ChrisCheang/GNCDemo/teensyGNC/teensyGNC.kicad_pcb

## KiCad design teensyGNC/teensyGNC.kicad_pcb (2026-09-21)

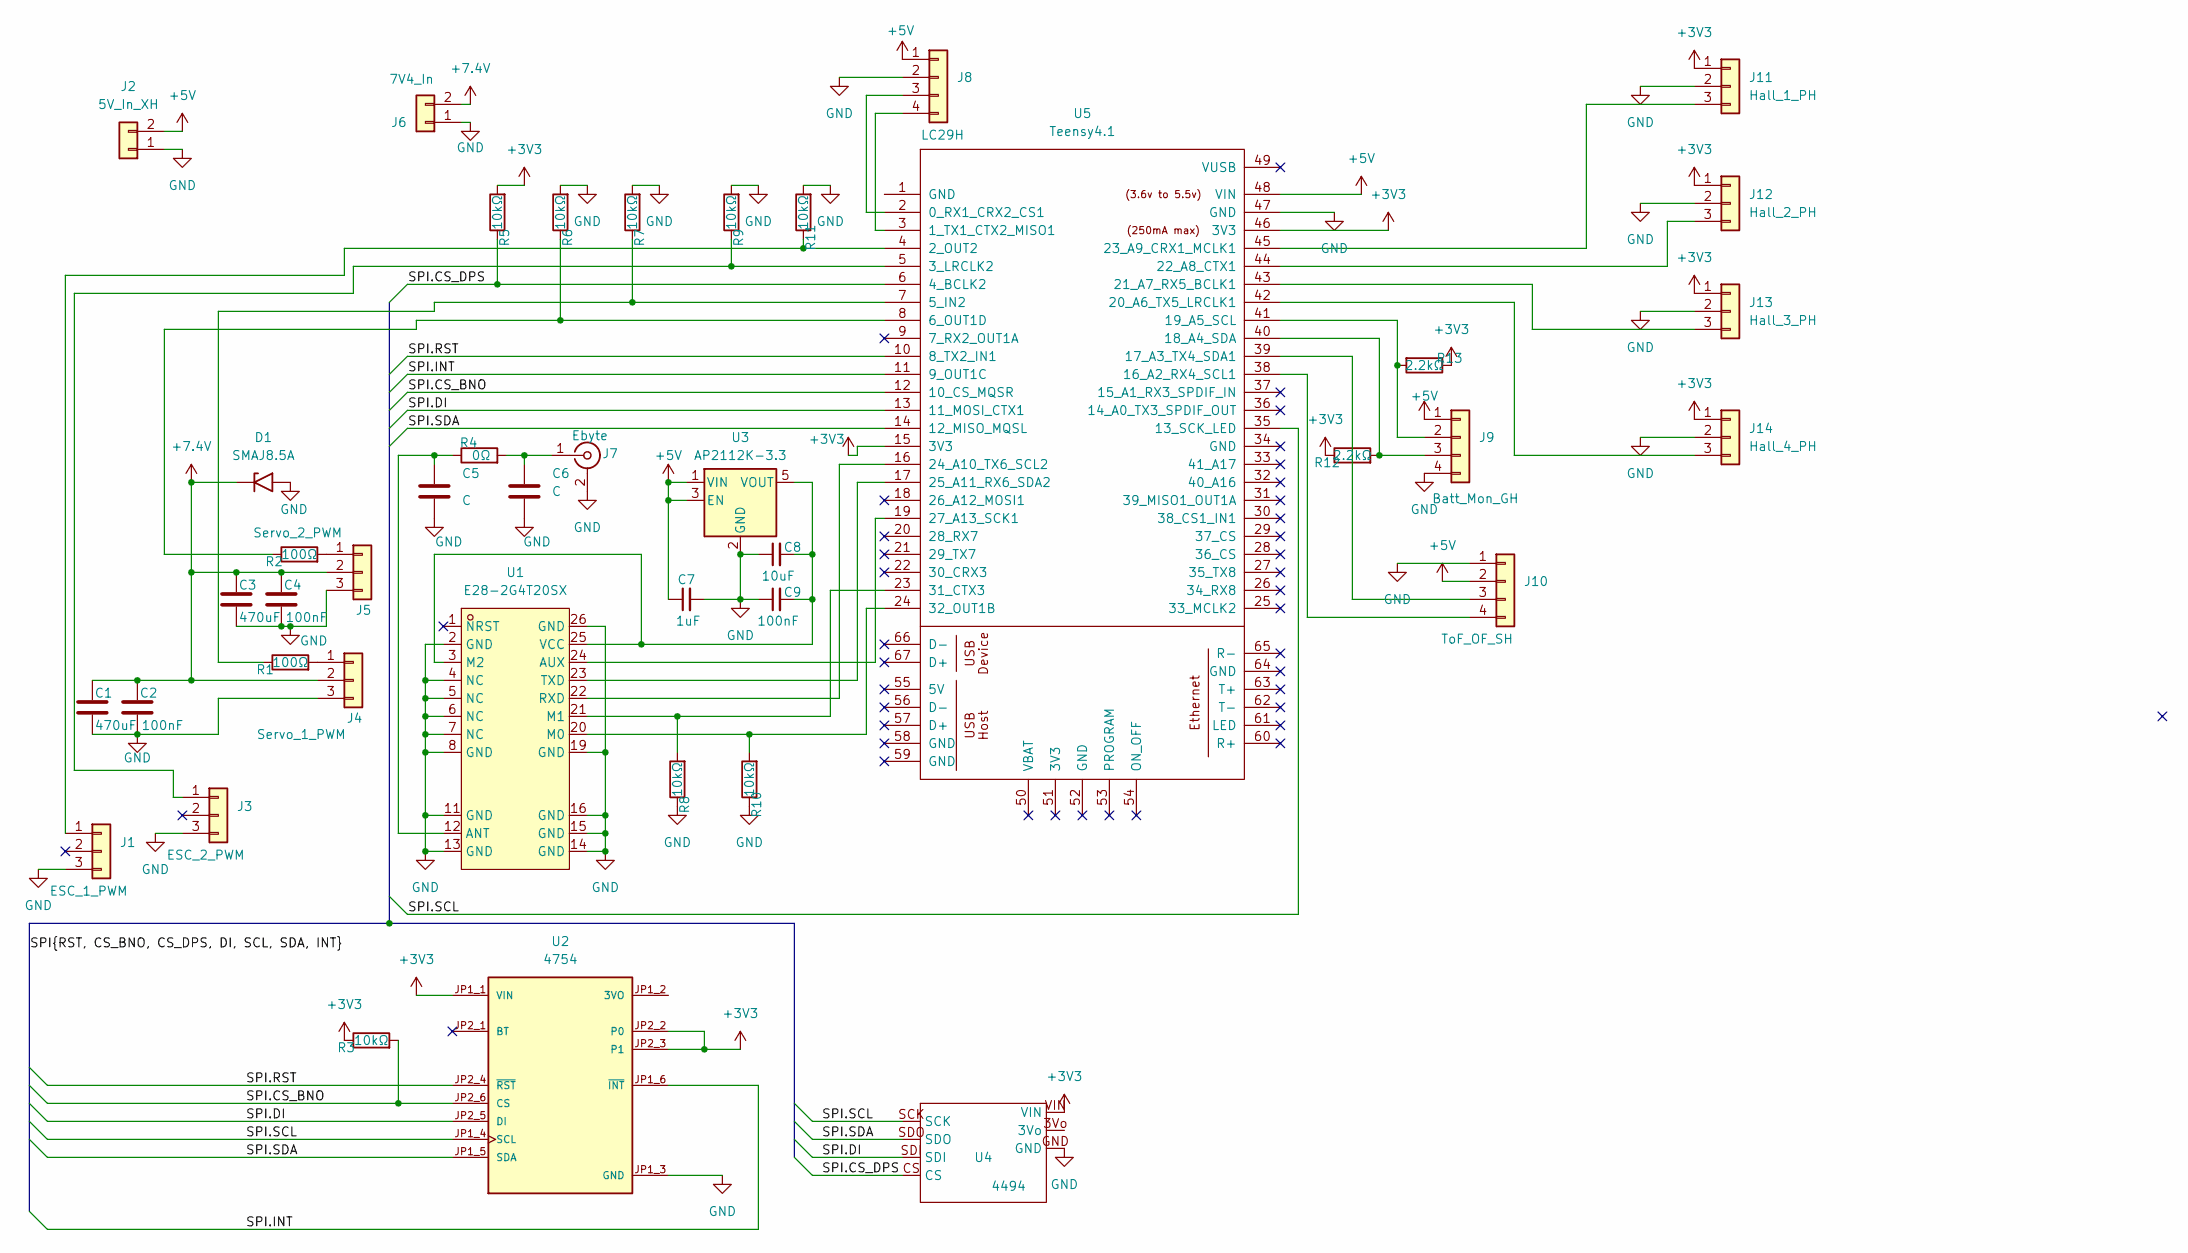
[picture p1: schematic teensyGNC.kicad_sch]

Parts:
C1, C3: 470uF; CP_EIA-7343-43_Kemet-X; LCSC Part # C7234
C2, C4, C9: 100nF; C_0603_1608Metric; LCSC Part # C14663
C5, C6: C; C_0603_1608Metric
C7: 1uF; C_0603_1608Metric; LCSC Part # C29936
C8: 10uF; C_0603_1608Metric; LCSC Part # C109457
D1: SMAJ8.5A; D_SMA; LCSC Part # C135018
J1: ESC_1_PWM; PinHeader_1x03_P2.54mm_Vertical
J2: 5V_In_XH; JST_XH_B2B-XH-AM_1x02_P2.50mm_Vertical; LCSC Part # C158012
J3: ESC_2_PWM; PinHeader_1x03_P2.54mm_Vertical
J4: Servo_1_PWM; PinHeader_1x03_P2.54mm_Vertical
J5: Servo_2_PWM; PinHeader_1x03_P2.54mm_Vertical
J6: 7V4_In; AMASS_XT30UPB-M_1x02_P5.0mm_Vertical; LCSC Part # C428721
J7: Ebyte; SMA_BAT_Wireless_BWSMA-KWE-Z001; LCSC Part # C496551
J8: LC29H; PinHeader_1x04_P2.54mm_Vertical
J9: Batt_Mon_GH; JST_GH_BM04B-GHS-TBT_1x04-1MP_P1.25mm_Vertical; LCSC Part # C161692
J10: ToF_OF_SH; JST_SH_BM04B-SRSS-TB_1x04-1MP_P1.00mm_Vertical; LCSC Part # C160390
J11: Hall_1_PH; JST_PH_B3B-PH-K_1x03_P2.00mm_Vertical; LCSC Part # C131339
J12: Hall_2_PH; JST_PH_B3B-PH-K_1x03_P2.00mm_Vertical; LCSC Part # C131339
J13: Hall_3_PH; JST_PH_B3B-PH-K_1x03_P2.00mm_Vertical; LCSC Part # C131339
J14: Hall_4_PH; JST_PH_B3B-PH-K_1x03_P2.00mm_Vertical; LCSC Part # C131339
R1, R2: 100Ω; R_0603_1608Metric; LCSC Part # C122970
R3, R5, R6, R7, R8, R9, R10, R11: 10kΩ; R_0603_1608Metric; LCSC Part # C25804
R4: 0Ω; R_0603_1608Metric; LCSC Part # C95177
R12, R13: 2.2kΩ; R_0603_1608Metric; LCSC Part # C4190
U1: E28-2G4T20SX; COMM-SMD_E28-2G4T20SX; MPN E28-2G4T20SX; LCSC Part # C42464206
U2: 4754; MODULE_4754; PARTREV 2021-03-16
U3: AP2112K-3.3; SOT-23-5; LCSC Part # C51118
U4: 4494; MODULE_4494
U5: Teensy4.1; Teensy41

Connections:
+3V3: J11.1, J12.1, J13.1, J14.1, R3.1, R5.2, R12.1, R13.1, U2.JP1_1 (VIN), U2.JP2_2 (P0), U2.JP2_3 (P1), U4.VIN, U5.15 (3V3), U5.46 (3V3)
+5V: C7.1, J2.2, J8.1, J9.1, J10.2, U3.1 (VIN), U3.3 (EN), U5.48 (VIN)
+7.4V: C1.1, C2.1, C3.1, C4.1, D1.1 (A1), J4.2, J5.2, J6.2
/SPI.CS_BNO: R3.2, U2.JP2_6 (CS), U5.12 (10_CS_MQSR)
/SPI.CS_DPS: R5.1, U4.CS, U5.6 (4_BCLK2)
/SPI.DI: U2.JP2_5 (DI), U4.SDI, U5.13 (11_MOSI_CTX1)
/SPI.INT: U2.JP1_6 (~INT), U5.11 (9_OUT1C)
/SPI.RST: U2.JP2_4 (~RST), U5.10 (8_TX2_IN1)
/SPI.SCL: U2.JP1_4 (SCL), U4.SCK, U5.35 (13_SCK_LED)
/SPI.SDA: U2.JP1_5 (SDA), U4.SDO, U5.14 (12_MISO_MQSL)
GND: C1.2, C2.2, C3.2, C4.2, C5.2, C6.2, C7.2, C8.1, C9.1, D1.2 (A2), J1.3, J2.1, J3.3, J4.3, J5.3, J6.1, J7.2 (Ext), J8.2, J9.4, J10.1, J11.2, J12.2, J13.2, J14.2, R6.2, R7.2, R8.1, R9.2, R10.1, R11.2, U1.2 (GND), U1.4 (NC), U1.5 (NC), U1.6 (NC), U1.7 (NC), U1.8 (GND), U1.11 (GND), U1.13 (GND), U1.14 (GND), U1.15 (GND), U1.16 (GND), U1.19 (GND), U1.26 (GND), U2.JP1_3 (GND), U3.2 (GND), U4.GND, U5.47 (GND)
unnamed: J1.1, R11.1, U5.4 (2_OUT2)
unnamed: J3.1, R9.1, U5.5 (3_LRCLK2)
unnamed: J4.1, R1.2
unnamed: J5.1, R2.2
unnamed: C6.1, J7.1 (In), R4.2
unnamed: J8.3, U5.2 (0_RX1_CRX2_CS1)
unnamed: J8.4, U5.3 (1_TX1_CTX2_MISO1)
unnamed: J9.2, R13.2, U5.41 (19_A5_SCL)
unnamed: J9.3, R12.2, U5.40 (18_A4_SDA)
unnamed: J10.3, U5.39 (17_A3_TX4_SDA1)
unnamed: J10.4, U5.38 (16_A2_RX4_SCL1)
unnamed: J11.3, U5.45 (23_A9_CRX1_MCLK1)
unnamed: J12.3, U5.44 (22_A8_CTX1)
unnamed: J13.3, U5.43 (21_A7_RX5_BCLK1)
unnamed: J14.3, U5.42 (20_A6_TX5_LRCLK1)
unnamed: C5.1, R4.1, U1.12 (ANT)
unnamed: U1.24 (AUX), U5.19 (27_A13_SCK1)
unnamed: R10.2, U1.20 (M0), U5.24 (32_OUT1B)
unnamed: R8.2, U1.21 (M1), U5.23 (31_CTX3)
unnamed: C8.2, C9.2, U1.3 (M2), U1.25 (VCC), U3.5 (VOUT)
unnamed: U1.22 (RXD), U5.16 (24_A10_TX6_SCL2)
unnamed: U1.23 (TXD), U5.17 (25_A11_RX6_SDA2)
unnamed: R1.1, R7.1, U5.7 (5_IN2)
unnamed: R2.1, R6.1, U5.8 (6_OUT1D)

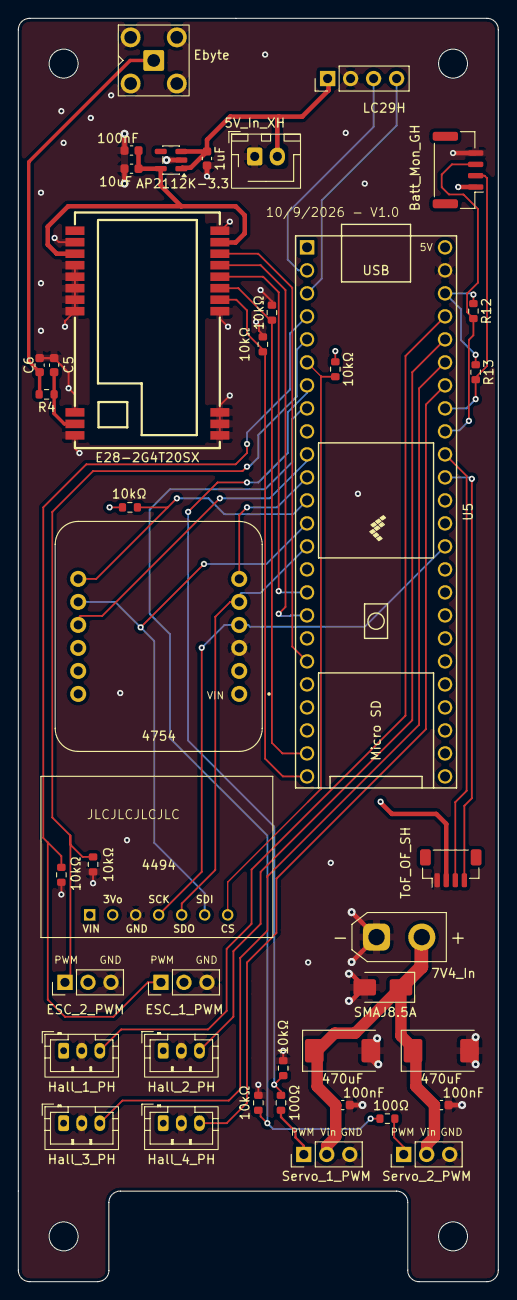
[picture p2: board teensyGNC.kicad_pcb from above]

Board: 4 copper layers, 53.0 x 139.5 mm, 42 parts (0 on the bottom side), 35 nets.
