ChrisCheang/GNCDemo/(commit log)

2026-07-16 Create IMUtest.ino
    First IMU testing code for the teensy 4.1 with SPI connection to BNO085
2026-07-16 Create IMUtest1.pde
    First version of Processing code for visualization
2026-07-17 Update IMUtest.ino
    Begins a calibration using 9-axis mode, then switches it to 6-axis game mode to remove yaw jumps as a result of magnetic interference
    [IMUtest.ino]
2026-07-17 Update IMUtest.ino
    Modified PWM signal to mirror imu roll angle on the servo, still compatible with the Processing code
2026-07-18 Create kinematics.py
    Updated version of kinematics.py from TVC-Hopper-Code to model the servo linkage kinematics in servo TVC concept 1, with a 3d visualization. So far only inverse kinematics (gimbal angles to servo angles).
2026-08-04 Update IMUtest.ino
    Slightly modified version with more adjustability for troublehshooting (in progress)
2026-08-25 Added PCB first version
    Added Kicad PCB, first version with all modules and connectors all connected (not checked yet)
    [teensyGNC.kicad_pcb, teensyGNC.kicad_sch]
2026-08-26 More amendments
    - Added mounting holes
    - Removed splits in the ground plane by removing all in1.cu plane traces
    - Added pull up/down resistors (check values)
    [teensyGNC.kicad_pcb, teensyGNC.kicad_sch]
2026-08-28 Update IMUtest.ino
    Added connection to 4494 DPS310 module, no filters or anything yet
2026-08-28 Moved LC29H onboard and to the top of the board
    [teensyGNC.kicad_pcb, teensyGNC.kicad_sch]
2026-08-30 Board width reduced
    [teensyGNC.kicad_pcb]
2026-09-02 Update IMUtest.ino
    Added single axis pwm control of one motor, 3v3 tentatively works fine for pwm control voltage. Middle of first testing period 3v3 pwm gives sufficiently stable motor speed regulation, but towards the end significant speed fluctuations (including sudden spikes to near full throttle, and motor sometimes cuts out during runs and enters beeping setups) were observed. Will need to verify if using 5v vs 3v3 is a factor to this, as well as the reason for such significant peaks. For now can remove level shifter from pcb, also recheck esc datasheet; speed fluctuations may be due to entering some sort of setup sequence due to e.g. power instabilities.
2026-09-03 Suggestions from Jack pt 1
    - LVL shifter removed, both servo and escs tested to be OK with 3v3
    - split plane removed, seems to be archaic method, and they haven't seen issues that require split ground planes to fix
    - Trace for antennae added, need to add proper components for the pi matching network and trace sizes
    [teensyGNC.kicad_pcb, teensyGNC.kicad_sch]
2026-09-04 Suggestions from Jack part 2 + some other changes
    - Ground pours on signal planes
    - Capacitors changed to flatter versions
    - Connector movements for teensy usb clearance
    - Silkscreen labels
    - Ran DRC; no errors just text warnings
    [teensyGNC.kicad_pcb, teensyGNC.kicad_sch]
2026-09-05 Small fixes
    - DRC now runs OK for all three ground pours (shifted ebyte around a little bit closer to teensy)
    [teensyGNC.kicad_pcb]
2026-09-05 DRC passed and offboard connector pinouts checked
    - All connectors vertical now for better cable management
    - LCSC numbers added as fields for jlcpcb assembly
    [teensyGNC.kicad_pcb, teensyGNC.kicad_sch]
2026-09-05 Test fabrication
    - Downloaded fabrication toolkit
    - Updated LCSC Part --> LCSC Part #
    - Test BOM and gerber creation using toolkit
    [Test_export_3_bom.csv, Test_export_3_designators.csv, Test_export_3_positions.csv, teensyGNC.kicad_pcb, teensyGNC.kicad_sch]
2026-09-06 First export sent to taobao JLCPCB for quoting + other stuff
    - Text labels added for components and connectors
    [Export_6_9_TeensyGNC_bom.csv, Export_6_9_TeensyGNC_designators.csv, Export_6_9_TeensyGNC_positions.csv, teensyGNC.kicad_pcb]
2026-09-09 V1.0 Order placed at JLCPCB
    - Some components changed to basic versions to lower cost a bit (TOTAL 96 USD!!!?? Do try and lower further for future versions, main cost seems to be extended part fees, maybe look into more hand soldered bits?)
    - Some JST connectors bought on taobao and assembled myself
    [Export_9_9_TeensyGNC_bom.csv, Export_9_9_TeensyGNC_designators.csv, Export_9_9_TeensyGNC_positions.csv, teensyGNC.kicad_pcb, teensyGNC.kicad_sch]
2026-09-10 Reorder
    Original order on 9-9 cancelled by jlcpcb for containing blind/buried vias, added DRC rule to check, removed blind/buried vias and then reordered
    [Export_10_9_TeensyGNC_bom.csv, Export_10_9_TeensyGNC_designators.csv, Export_10_9_TeensyGNC_positions.csv, teensyGNC.kicad_pcb]
2026-09-13 Update IMUtest.ino
    Added watchdog timer (but main improvement to increased stability is probably the switch to PDB BEC and better power connectiors) and first testing version of the kalman filter (+ added some foam to the dps310, but may not be thick enough, need more testing, focus on filter first), parameter tuning and read up next
    [IMUtest.ino]
2026-09-20 Create altkalman.ino
    First working version of altitude kalman filtering using a 2DoF linear kalman filter. Process noise Q is very low (trusts the instantaneous changes of the accelerometer more, note that the accelerometer imu feeds into the prediction step as it is directly a part of the system model) and measurement noise R high (doesn't trust barometer instantaneous movements and transients, so kalman gain K, i.e. the contribution given to the final updated altitude, is very low), such that instantaneous movements are captured with the accelerometer, while the barometer corrects drift. Note that as long as K is not exactly zero, it multiplies with the innovation (difference between measu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
    [altkalman.ino]
2026-09-21 Update altkalman.ino
    First on vehicle board test, switched acceleration direction from Z+ (breadboard testing) to X+ (vehicle mounting)
2026-09-21 ! CRITICAL FIX !
    5V Input plug was placed the wrong way around, now flipped back to the correct direction on the board. For the V1.0 deliveries, the first board might have had its ebyte power voltage converter fried (not tested yet), jst xh flipped manually (steps in notebook) for successful testing of altitude control on vehicle. For second board, will need to flip the jst xh first.
    [teensyGNC.kicad_pcb, teensyGNC.kicad_sch]
2026-09-23 Update IMUtest.ino
    First tests of integrated servo action on the vehicle
2026-10-03 Update altkalman.ino
    Corrected roll calculation and updated body frame (north west up when in static condition)
    [altkalman.ino]
2026-10-05 Update wiredtelemetry.py
    Changed 3D axes to a top down 2D motion plot
2026-10-05 Update wiredtelemetry.py
    Fixed 2D window size
    [wiredtelemetry.py]
2026-10-05 Update altkalman.ino
    - NWU frame quaternion compensation completed
    - 6d kalman filter partially implemented with altitude gyroscope compensation done
    - Optical flow data reads successfully, but compensation is not yet implemented correctly
    [altkalman.ino]
2026-10-06 Update altkalman.ino
    Note: optical flow still doesn't work, saving here for easier iteration and trials of modified older versions
    [altkalman.ino]
2026-10-07 Update altkalman.ino
    Best version of optical flow so far, for some reason removing the compensation terms (even though the mtf-01p doesn't seem to have an on board gyro) provides better results overall, even if pitch and yaw is still not being compensated. Will try another method (using qw, qx, qy, qz to calculate the expected deviation of the camera ground point from startup orientation) next time. Also for some reason the integrated distance is ~3x lower, tried changing the kalman filter R and Q process and measurement noise variances to alter the balance but need to balance that with filter response so a 3x artificial scaling factor added in for now
    [altkalman.ino]
2026-10-08 Update altkalman.ino
    work in progress to try and implement post-kalman filter tilt compensation
2026-10-08 Update altkalman.ino
    Added a taken_off boolean (2cm above height CoM) where px, py, vx, vy is fixed at 0 before take off, and after takeoff a bias is subtracted from px_c and py_c (post-kalman correct positions) to zero the beginning state properly
    (for future use extend this to be a state machine)
    [altkalman.ino]
2026-10-10 Update altkalman.ino
    - Some gains tuned, servo motion suppressed below 5cm floor altitude, timer added to add target altitude hop profile
2026-10-10 Update wiredtelemetry.py
    - Altitude target plot added
2026-10-10 Update wiredtelemetry.py
    Most updated version, some quick flight tuning of PID parameters, though still seems to be unstable once oscillations begin (seen in the test today 11:02 pm after manual intervention, instabilities grow). Roll control still needs work, flipped roll control signs from previous runs but seems to have limited effect, thus still needs more motor running testing (larger gains to directly observe effect etc.).
    [wiredtelemetry.py]
2026-10-11 Create wiredtelemetry_playback.py
    new file to replot the results of a wiredtelemetry.py output csv file, when run a window pops out for the user to choose the telemetry_datetime.csv file from the same folder.
2026-10-11 Update altkalman.ino
    First untouched takeoff and landing achieved 11-10 22:20:56
    New features and modifications:
    - More iterative adjustment of gains, mostly reductions for tvc inner loop (still needs work, see below caveats)
    - Esc output lock that cuts main motor power once altitude is detected to exceed CoM_height + 0.05 (i.e. takeoff) then back under again to prevent bounces
    Some caveats:
    - System is still unstable as visible in the telemetry plot, oscillations in pitch, yaw and roll all growing or constant amplitude (roll seems to be drifting as well, perhaps due to capped esc outputs or insufficient gains)
    - According to telemetry the northwest drift is detected in the optical flo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
2026-10-11 Update wiredtelemetry_playback.py
    - Matching x axis for easier comparison
    - Colour gradient on xy plot for time identification
    - Target pitch and yaw angles plotted as dotted lines
2026-10-11 Update wiredtelemetry_playback.py
    - terminal prompted start and end time window adjustment
    - source filename displayed on the top left as part of window name
2026-10-13 Update altkalman.ino
    Added i2c ina bm reading of voltage, current and power
2026-10-13 Update altkalman.ino
    i2cinabm update rate reduced to 10Hz (non-blocking)
2026-10-14 Update altkalman.ino
    Version with altitude compensation to calibrate start altitude within +- <10 mm
2026-10-14 Update wiredtelemetry.py
    Added hover throttle updating based on battery voltage, currently uses manufaucturer data and is untested
2026-10-14 Update altkalman.ino
    Code double counted thrust for hover thrust estimation, now fixed
2026-10-14 Update altkalman.ino
    forgot println
2026-10-16 Update altkalman.ino
    Loads of tests done, attitude control is now stable thanks to much reduced inner loop gains. Software changes:
    - outer loop now runs at 50 Hz
    - different center values for pitch and yaw, offsets set in code (also pitch and yaw labelling appears to be flipped, fix in future)
    - more aggressive position control gains to try and improve horizontal response, but the inaccuracies of the ToF compensation and value acquisition now becomes the main issue, will need to target fix asap (better bracket, more accurate measurements, figure out exactly what the onboard compensation is, retest velocity based compensation)
2026-10-16 Update altkalman.ino
    First visible demonstration of active attitude and positional control. Battery voltage at 11.6V during flight (battery voltage at no load is 12.3V). Next steps are to improve optical flow sensing (bracket, measurements, test velocity based offset, understand stock compensation better), characterise motor and servos separately, and improve vehicle hardware balancing (and sims and fix code labelling)
2026-11-11 Create ntrip_serial.py
    First successful ntrip client connection, serial connection to teensy. Beware of different baud rates for the LC29H and usb serial
2026-11-11 Update ntrip_serial.py
    timeout increased from 0.05 to 0.1 for more reliable connection, can increase further if needed (but printing frequency reduces). LC29H configured to output GNGGA sentences at 10Hz
